tokirobot/PSI1_Hardware/PSI1_STL/bodyframe/main_body.stl

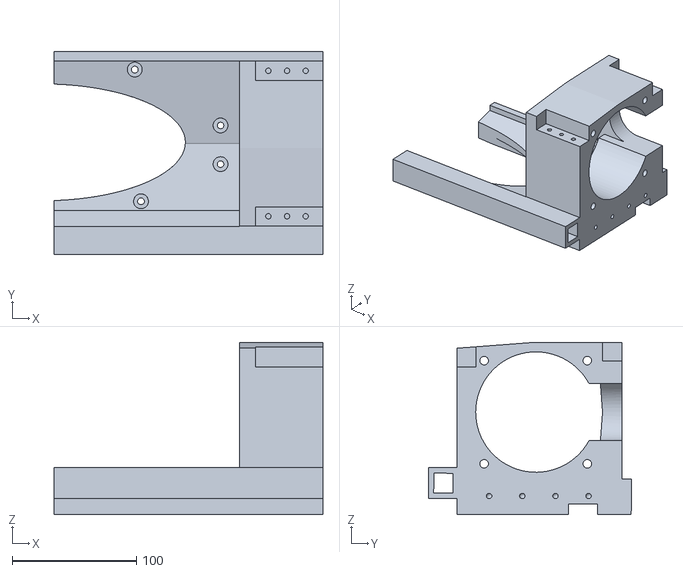
[picture p14: CAD file, 2024-09-26]
PSI1_STL/bodyframe/main_body.stl
216.4 x 163.0 x 138.7
