tokirobot/PSI1_Hardware/PSI1_STEP/bodyframe/body_frame.step

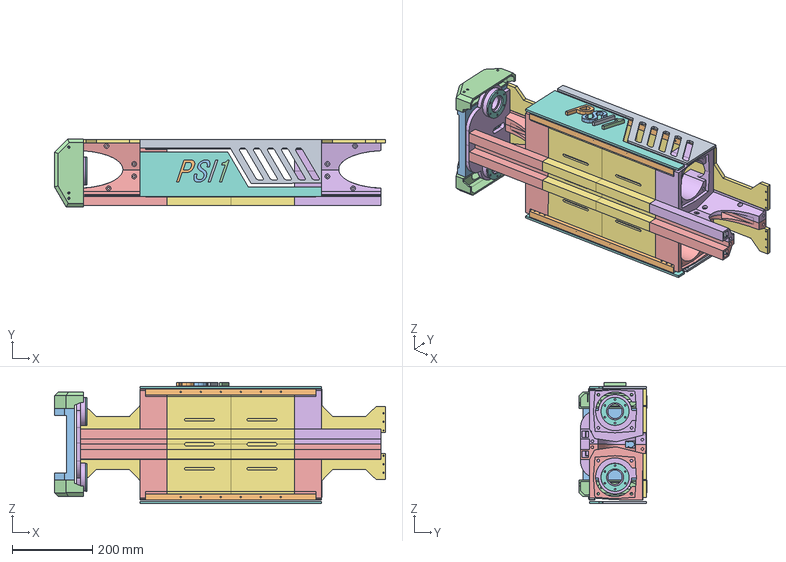
[picture p15: CAD file, 2024-09-26]
PSI1_STEP/bodyframe/body_frame.step
827.0 x 170.4 x 303.1 mm
