tokirobot/PSI1_Hardware/PSI1_STEP/kneedrive/kneedrive.step

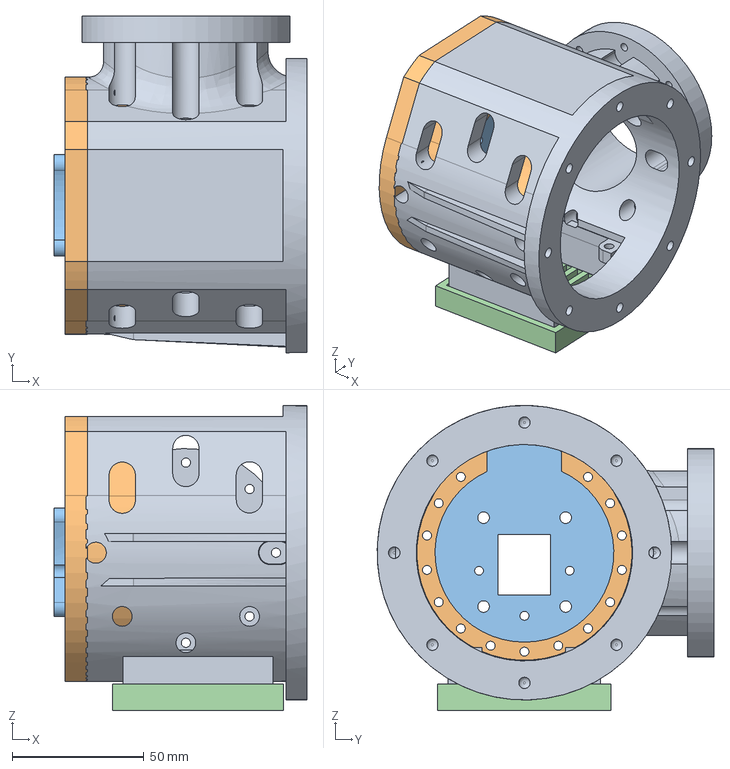
[picture p17: CAD file, 2024-09-26]
PSI1_STEP/kneedrive/kneedrive.step
96.1 x 128.0 x 116.0 mm
