tokirobot/PSI1_Hardware/PSI1_STEP/leg1/linear_slider.step

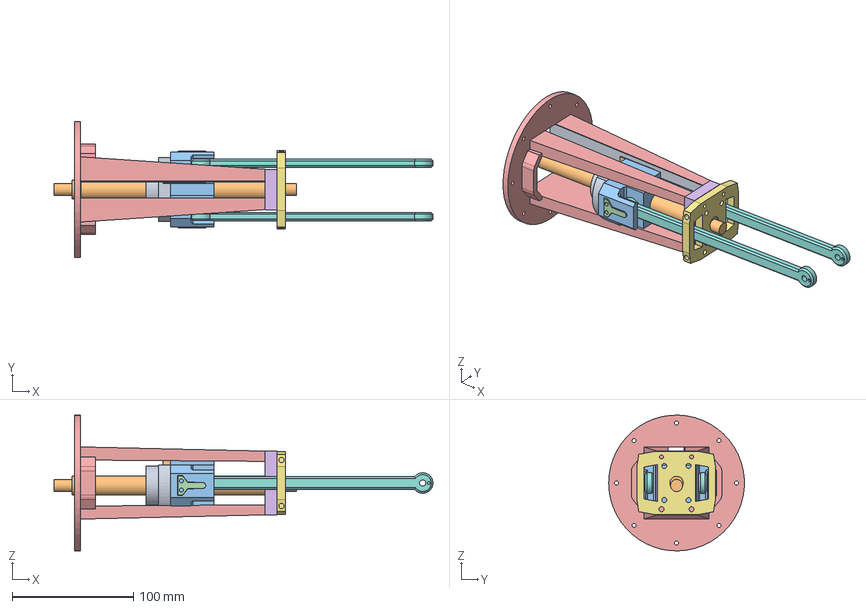
[picture p18: CAD file, 2024-09-26]
PSI1_STEP/leg1/linear_slider.step
312.6 x 111.9 x 111.9 mm
