tokirobot/PSI1_Hardware/PSI1_STEP/leg2/leg2.step

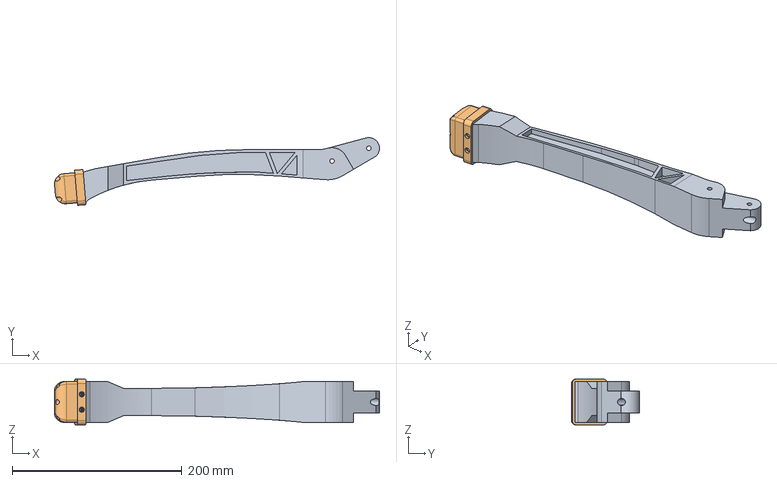
[picture p19: CAD file, 2024-09-26]
PSI1_STEP/leg2/leg2.step
382.8 x 79.9 x 54.0 mm
