tokirobot/PSI1_Hardware/PSI1_STL/bodyframe/yholoder_with_buttoncase.stl

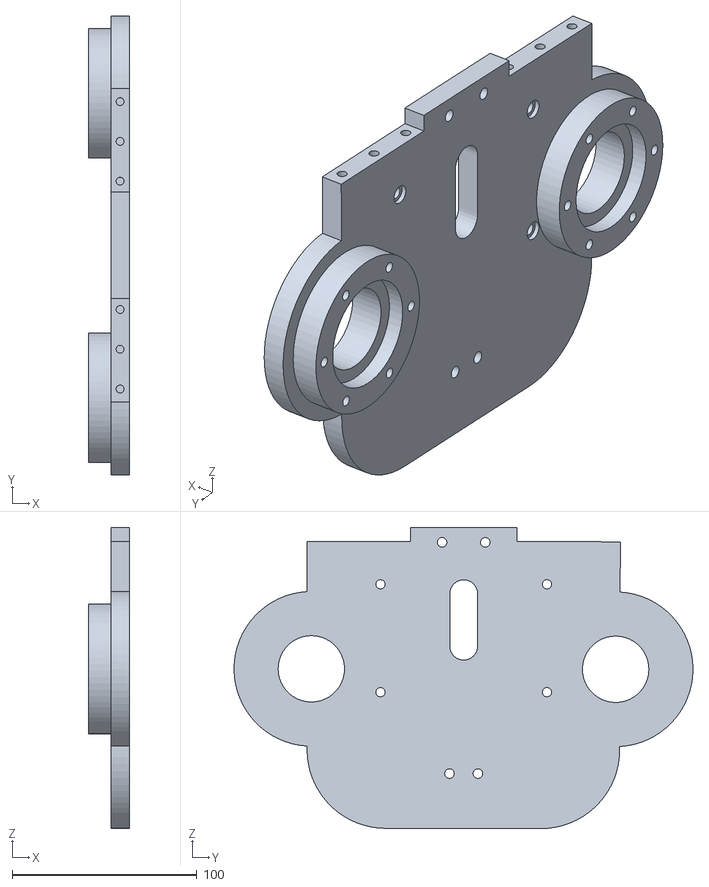
[picture p20: CAD file, 2024-09-26]
PSI1_STL/bodyframe/yholoder_with_buttoncase.stl
22.0 x 248.2 x 162.8
