tokirobot/PSI1_Hardware/PSI1_STL/kneedrive/knee_connector_bottomdown.stl

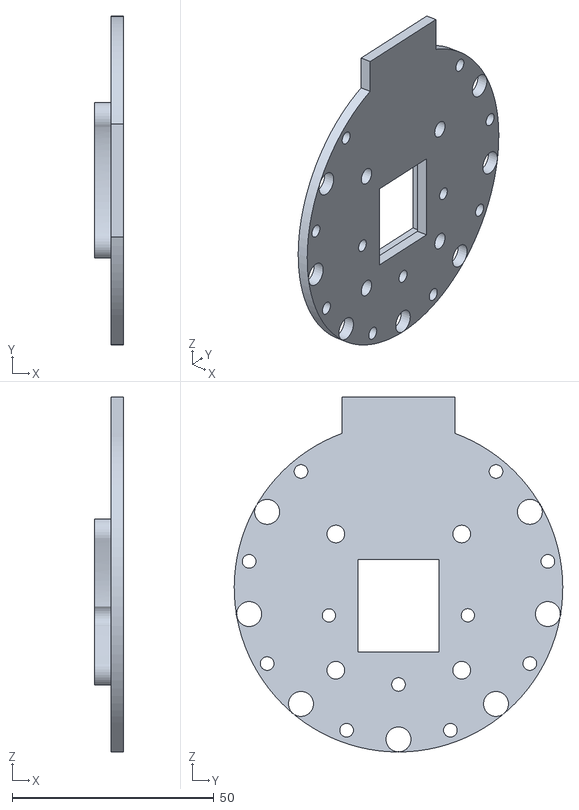
[picture p21: CAD file, 2024-09-26]
PSI1_STL/kneedrive/knee_connector_bottomdown.stl
7.10 x 81.5 x 88.0
