tokirobot/PSI1_Hardware/PSI1_STL/leg2/foot.stl

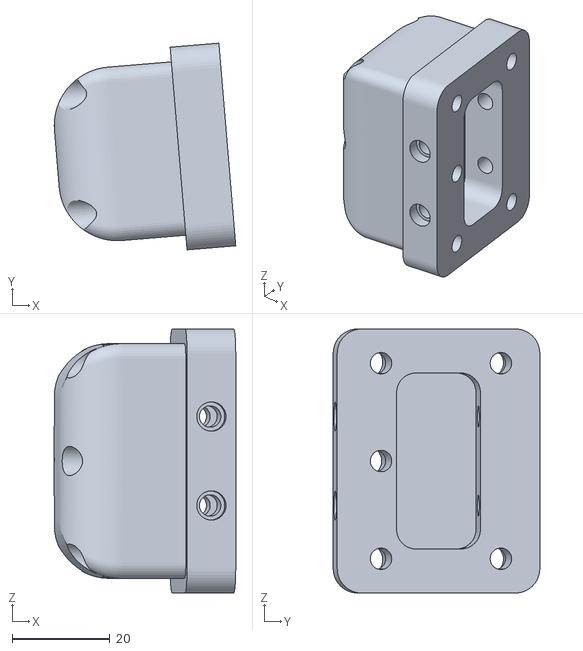
[picture p22: CAD file, 2024-09-26]
PSI1_STL/leg2/foot.stl
37.1 x 42.3 x 54.0
