tokirobot/PSI1_Hardware/PSI1_STL/xaxisdrive/output1_HIP.stl

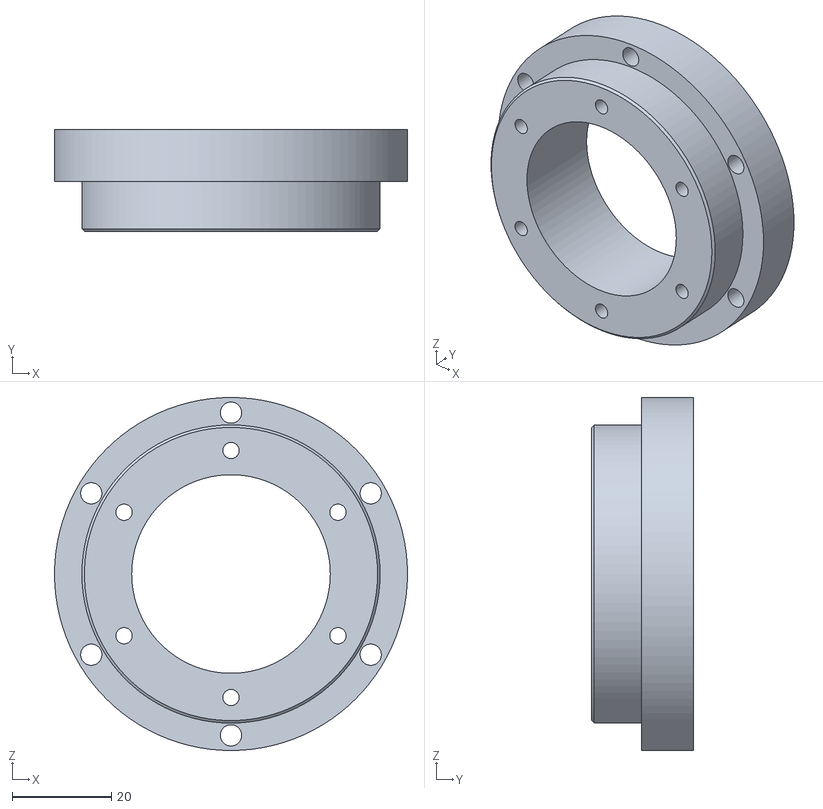
[picture p23: CAD file, 2024-09-26]
PSI1_STL/xaxisdrive/output1_HIP.stl
71.1 x 20.5 x 71.1
