tokirobot/PSI1_Hardware/PSI1_STL/yaxisdrive/sungear.stl

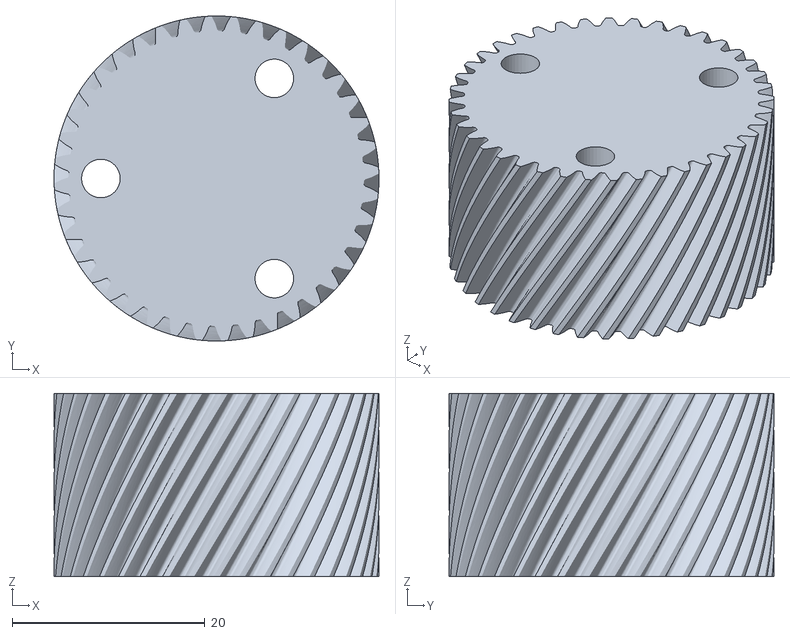
[picture p24: CAD file, 2024-09-26]
PSI1_STL/yaxisdrive/sungear.stl
33.7 x 33.7 x 19.0
