tokirobot/PSI1_Hardware/PSI1_STEP/bodyframe/emergency_button_.step

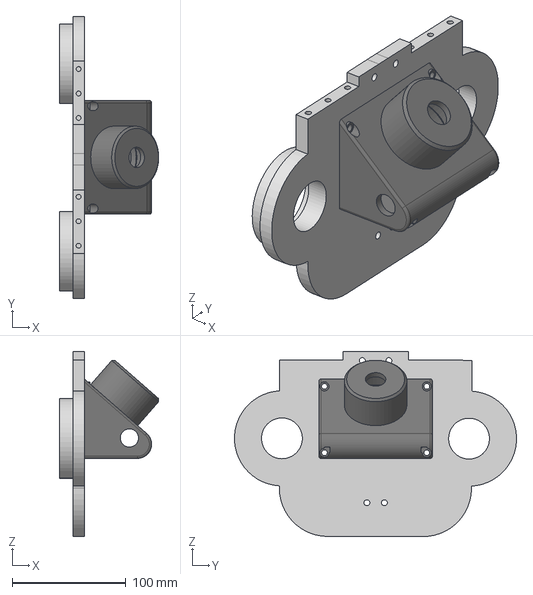
[picture p25: CAD file, 2024-09-26]
PSI1_STEP/bodyframe/emergency_button_.step
87.5 x 248.0 x 162.8 mm
