tokirobot/PSI1_Hardware/PSI1_STEP/leg1/linear_actuator_case.step

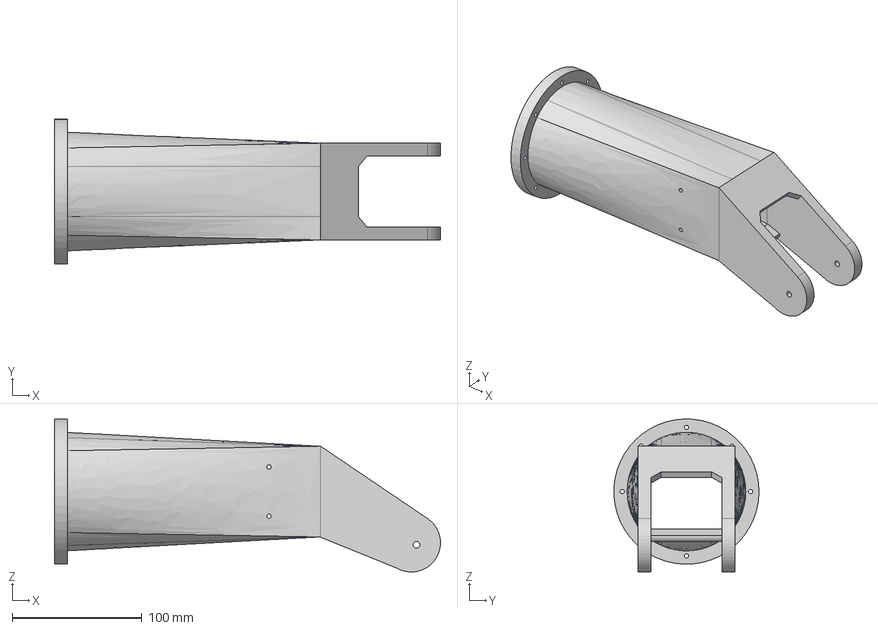
[picture p26: CAD file, 2024-09-26]
PSI1_STEP/leg1/linear_actuator_case.step
297.7 x 111.9 x 118.0 mm
