tokirobot/PSI1_Hardware/PSI1_STL/bodyframe/face_cover_eyeled.stl

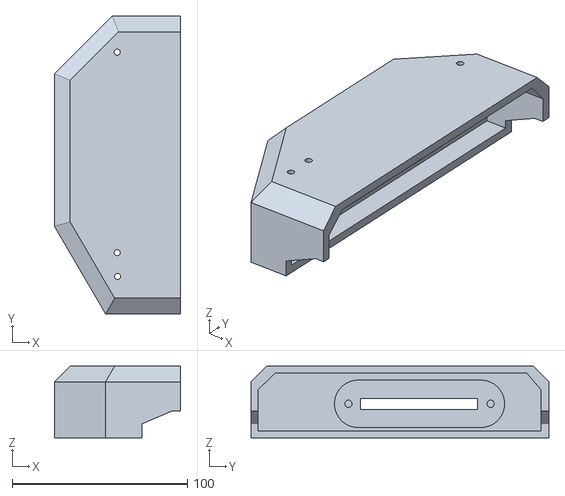
[picture p27: CAD file, 2024-09-26]
PSI1_STL/bodyframe/face_cover_eyeled.stl
72.0 x 170.0 x 41.0
