tokirobot/PSI1_Hardware/PSI1_STL/kneedrive/knee_drive_v2.stl

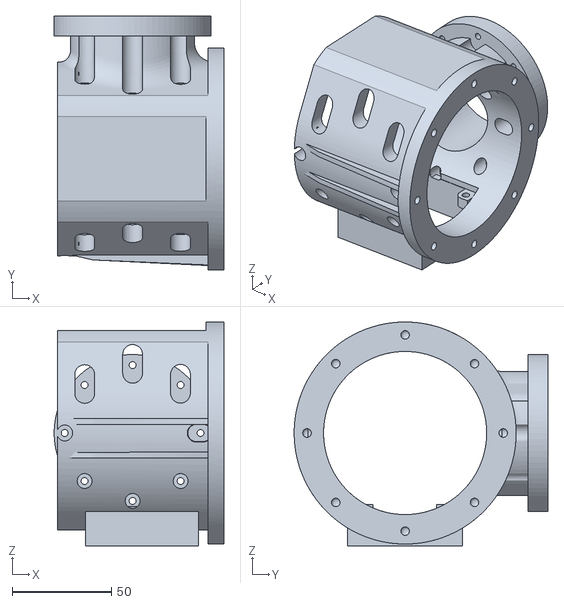
[picture p28: CAD file, 2024-09-26]
PSI1_STL/kneedrive/knee_drive_v2.stl
85.6 x 128.0 x 113.0
