tokirobot/PSI1_Hardware/PSI1_STL/leg1/スライダー滑り2.stl

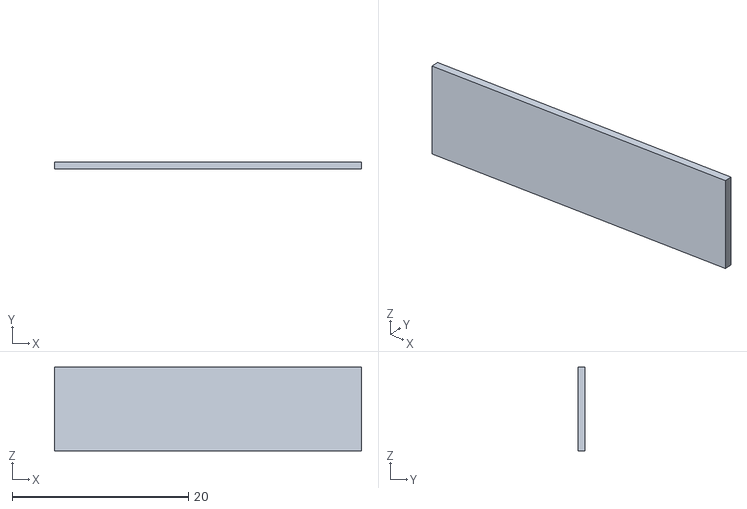
[picture p29: CAD file, 2024-09-26]
PSI1_STL/leg1/スライダー滑り2.stl
34.9 x 0.85 x 9.50
