tokirobot/PSI1_Hardware/PSI1_STL/xaxisdrive/bearingholder_HIP.stl

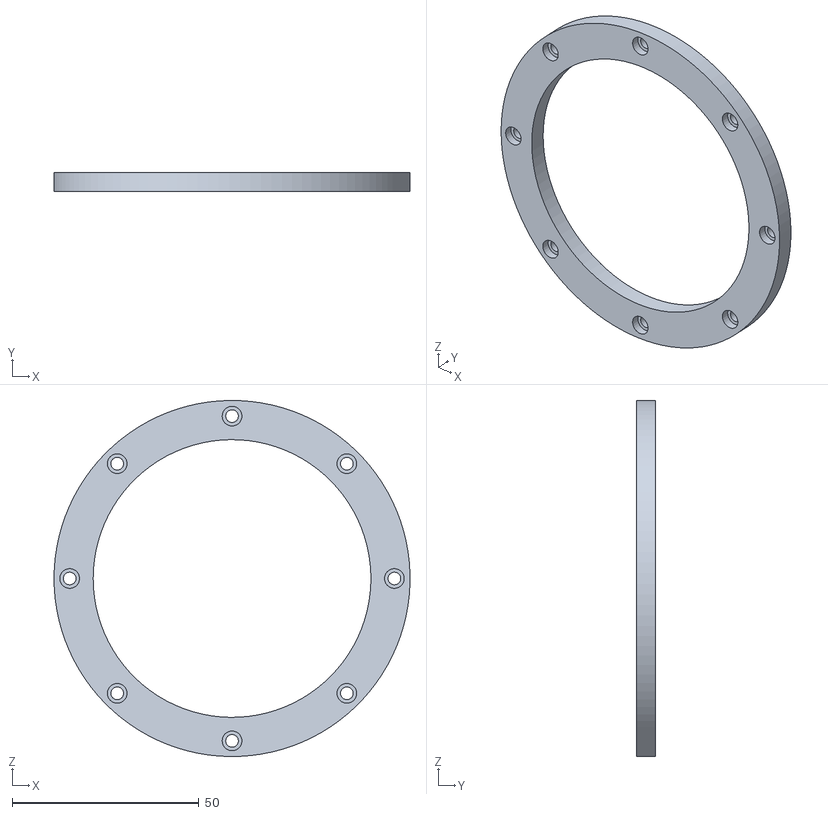
[picture p30: CAD file, 2024-09-26]
PSI1_STL/xaxisdrive/bearingholder_HIP.stl
95.4 x 5.00 x 95.4
