tokirobot/PSI1_Hardware/PSI1_STL/bodyframe/P.stl

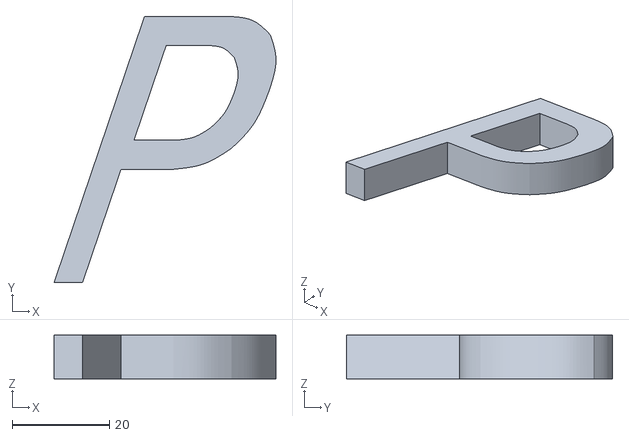
[picture p31: CAD file, 2024-09-26]
PSI1_STL/bodyframe/P.stl
45.8 x 54.9 x 9.00
