tokirobot/PSI1_Hardware/PSI1_STL/kneedrive/knee_motor_holder_bottomdown.stl

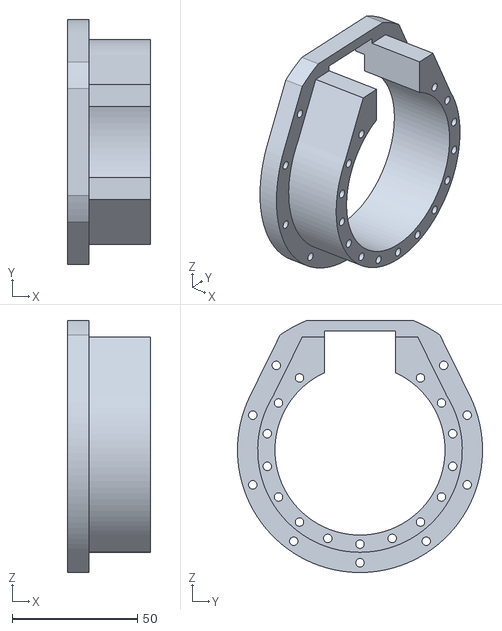
[picture p32: CAD file, 2024-09-26]
PSI1_STL/kneedrive/knee_motor_holder_bottomdown.stl
33.0 x 98.0 x 100.8
