tokirobot/PSI1_Hardware/PSI1_STL/leg1/lod_holder.stl

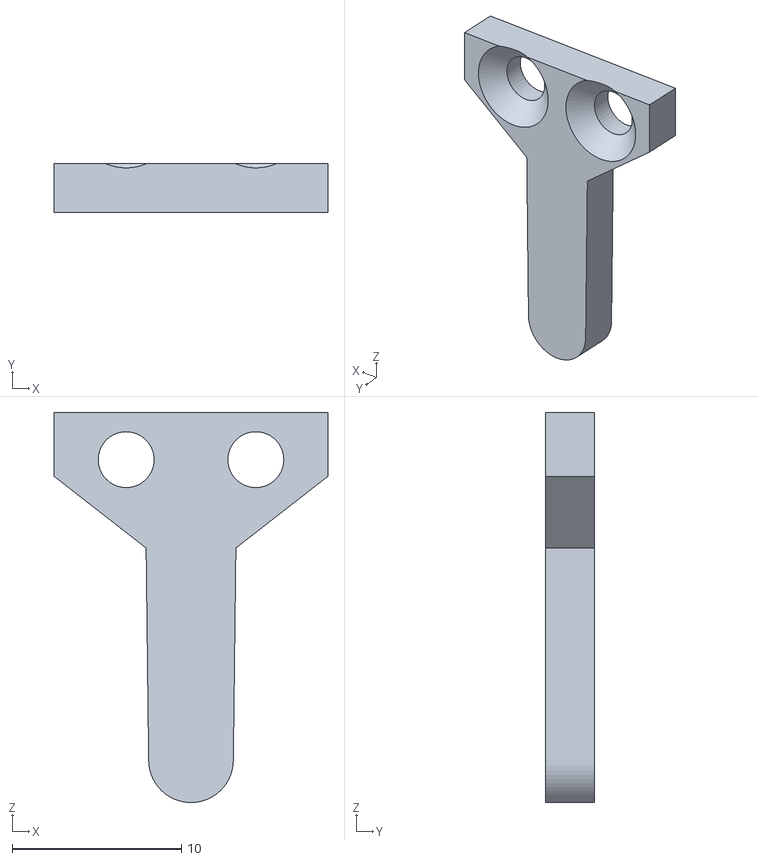
[picture p33: CAD file, 2024-09-26]
PSI1_STL/leg1/lod_holder.stl
16.2 x 2.90 x 23.0
