tokirobot/PSI1_Hardware/PSI1_STL/xaxisdrive/motor_mount_HIP.stl

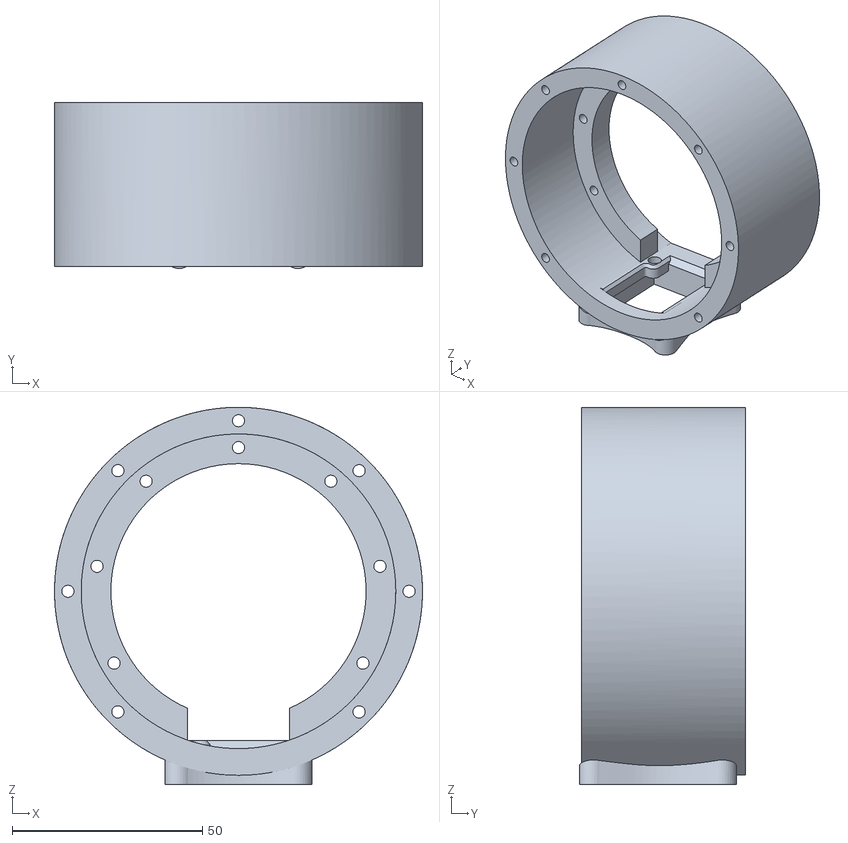
[picture p34: CAD file, 2024-09-26]
PSI1_STL/xaxisdrive/motor_mount_HIP.stl
96.6 x 43.6 x 99.1
