tokirobot/PSI1_Hardware/PSI1_STL/yaxisdrive/planetary_career_bottom.stl

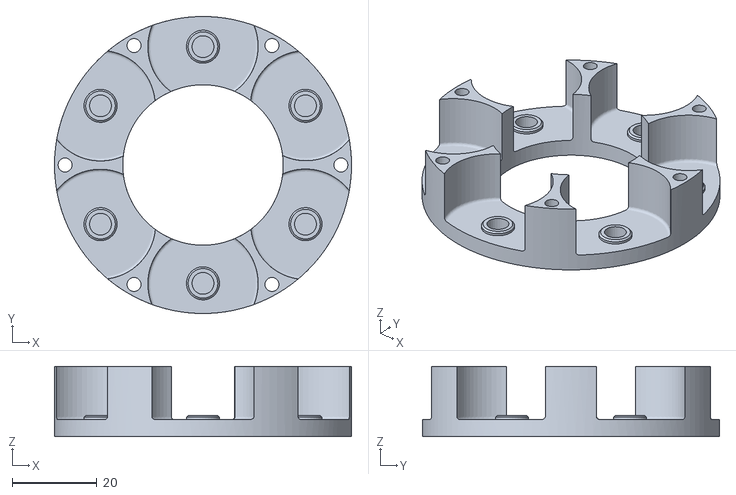
[picture p35: CAD file, 2024-09-26]
PSI1_STL/yaxisdrive/planetary_career_bottom.stl
70.0 x 70.0 x 16.5
