tokirobot/PSI1_Hardware/PSI1_STL/kneedrive/fancase.stl

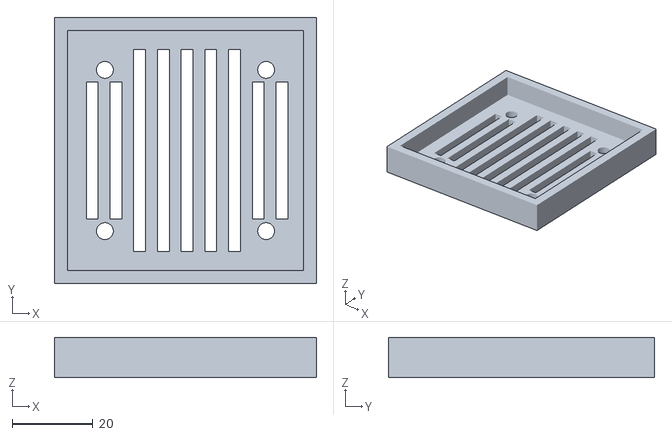
[picture p37: CAD file, 2024-09-26]
PSI1_STL/kneedrive/fancase.stl
65.0 x 66.0 x 10.0
