tokirobot/PSI1_Hardware/PSI1_STL/leg1/linear_frame_v2.stl

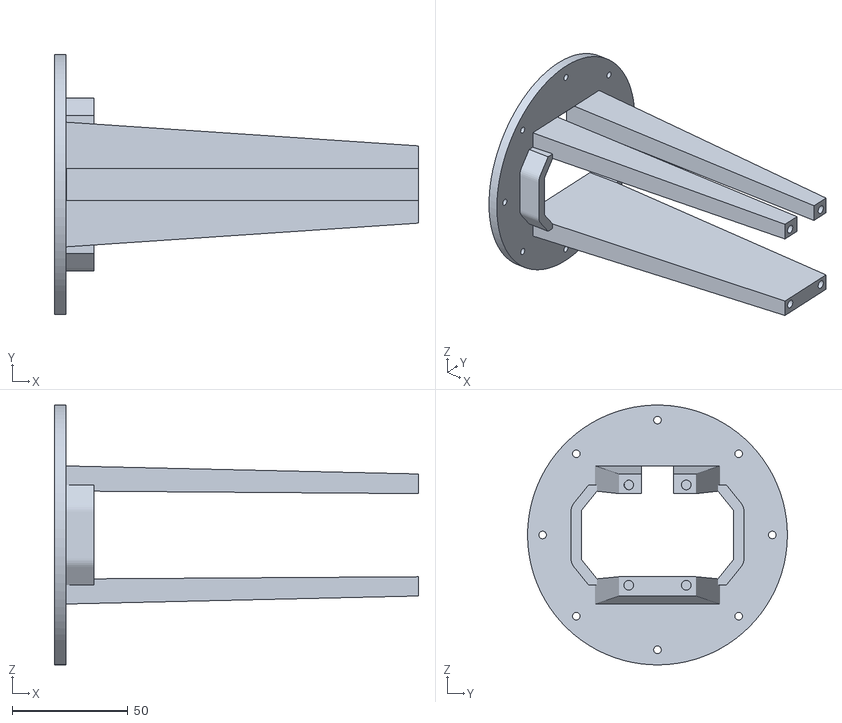
[picture p38: CAD file, 2024-09-26]
PSI1_STL/leg1/linear_frame_v2.stl
156.9 x 112.0 x 112.0
