tokirobot/PSI1_Hardware/PSI1_STL/xaxisdrive/cybercase.stl

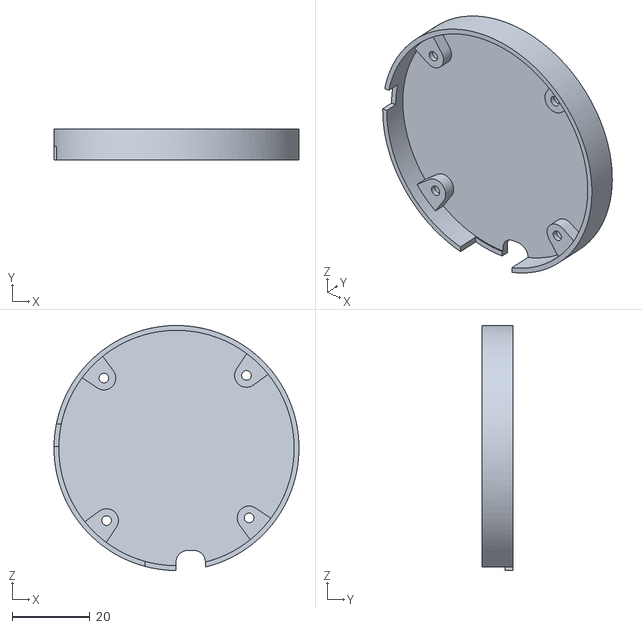
[picture p39: CAD file, 2024-09-26]
PSI1_STL/xaxisdrive/cybercase.stl
63.2 x 7.90 x 63.2
