tokirobot/PSI1_Hardware/PSI1_STL/yaxisdrive/planetary_career_top.stl

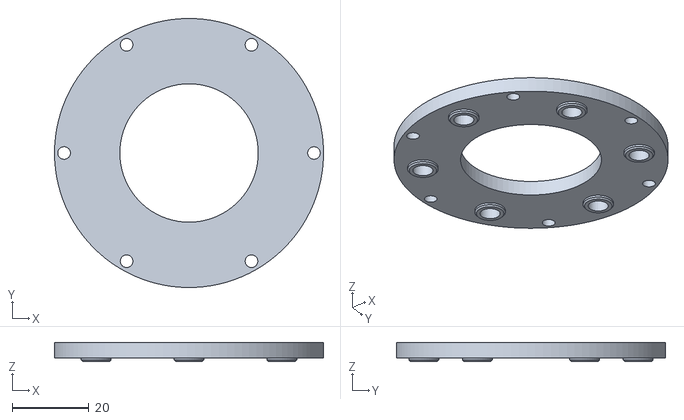
[picture p40: CAD file, 2024-09-26]
PSI1_STL/yaxisdrive/planetary_career_top.stl
70.0 x 70.0 x 4.95
