tokirobot/PSI1_Hardware/PSI1_STL/bodyframe/under_frame.stl

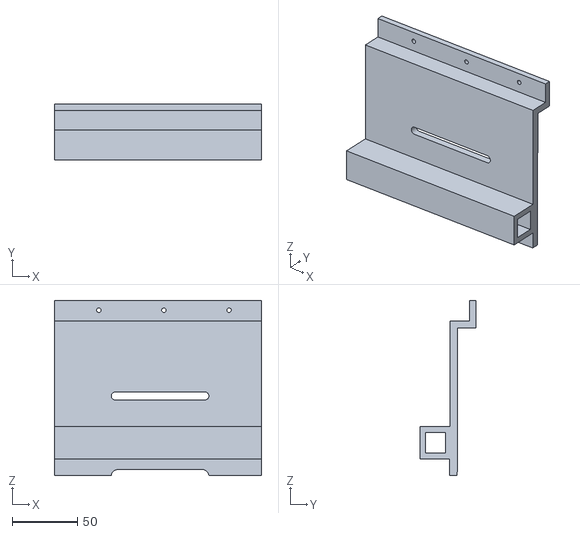
[picture p41: CAD file, 2024-09-26]
PSI1_STL/bodyframe/under_frame.stl
159.0 x 42.9 x 134.5
