tokirobot/PSI1_Hardware/PSI1_STL/yaxisdrive/connector_SHOULDER.stl

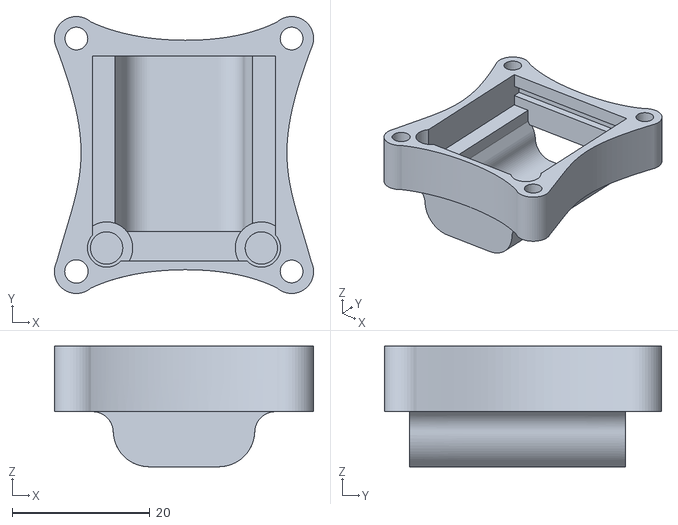
[picture p43: CAD file, 2024-09-26]
PSI1_STL/yaxisdrive/connector_SHOULDER.stl
37.6 x 40.2 x 17.5
