tokirobot/PSI1_Hardware/PSI1_STL/bodyframe/I.stl

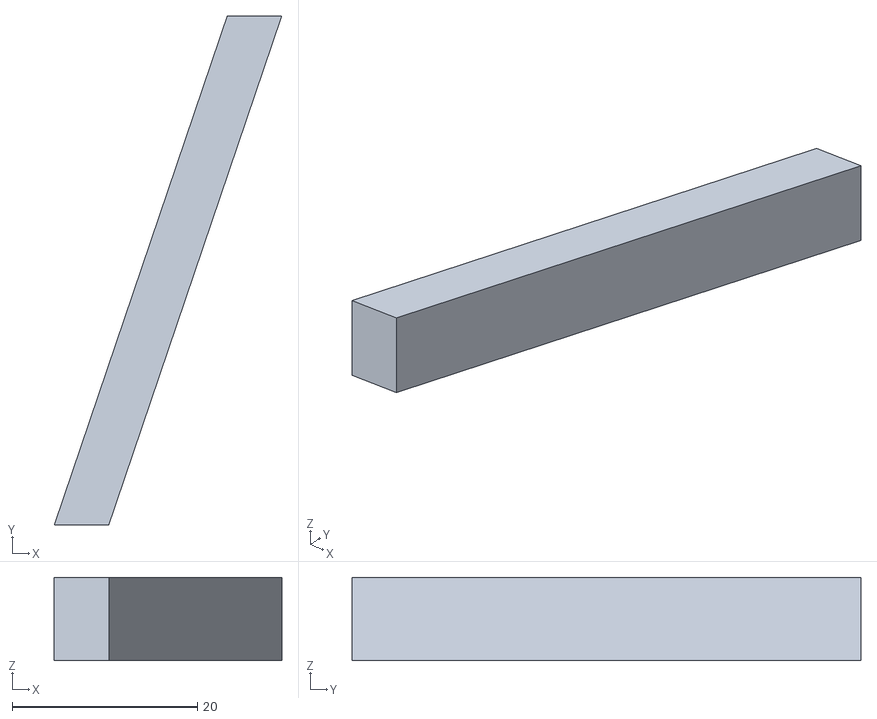
[picture p44: CAD file, 2024-09-26]
PSI1_STL/bodyframe/I.stl
24.5 x 54.9 x 9.00
