tokirobot/PSI1_Hardware/PSI1_STL/leg1/linear_frame_holder.stl

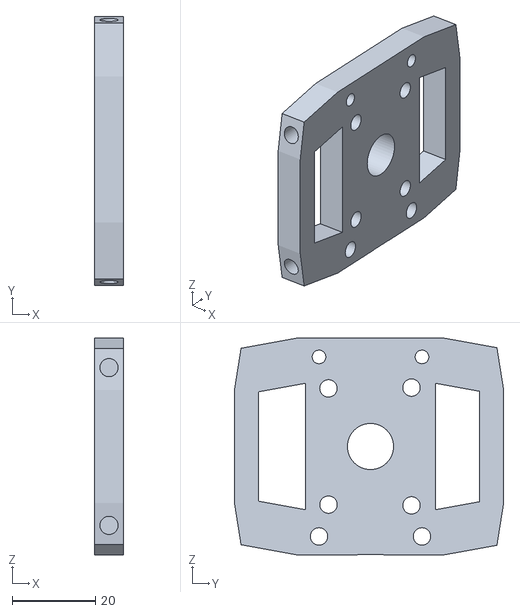
[picture p45: CAD file, 2024-09-26]
PSI1_STL/leg1/linear_frame_holder.stl
7.00 x 64.8 x 52.3
