tokirobot/PSI1_Hardware/PSI1_STL/xaxisdrive/planetary_98%.stl

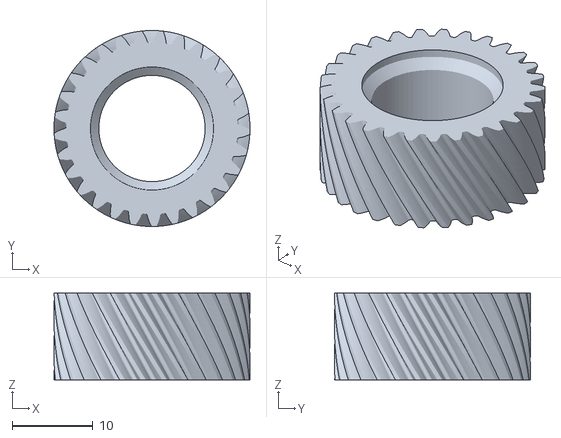
[picture p46: CAD file, 2024-09-26]
PSI1_STL/xaxisdrive/planetary_98%.stl
24.3 x 24.3 x 10.8
