tokirobot/PSI1_Hardware/PSI1_STL/yaxisdrive/Y_axis_holder_SHOULDER.stl

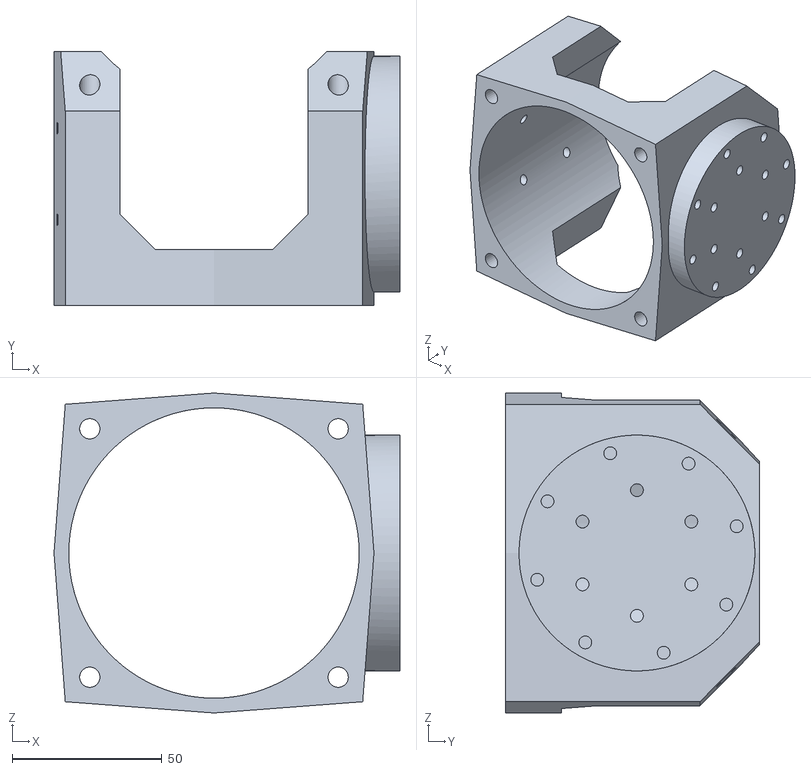
[picture p47: CAD file, 2024-09-26]
PSI1_STL/yaxisdrive/Y_axis_holder_SHOULDER.stl
115.6 x 85.0 x 106.9
