tokirobot/PSI1_Hardware/PSI1_STL/bodyframe/y_bearing_holder.stl

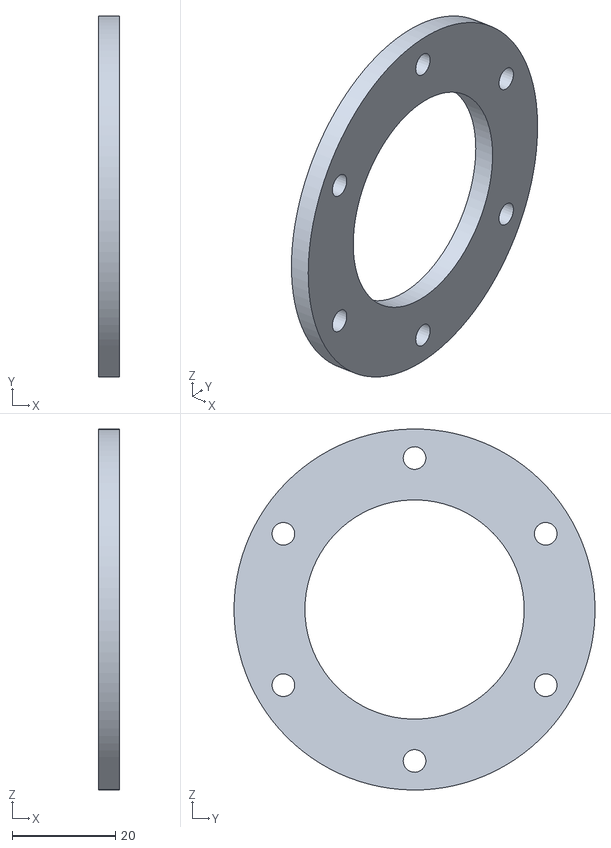
[picture p48: CAD file, 2024-09-26]
PSI1_STL/bodyframe/y_bearing_holder.stl
4.00 x 70.0 x 70.0
