tokirobot/PSI1_Hardware/PSI1_STL/leg1/回転支え2.stl

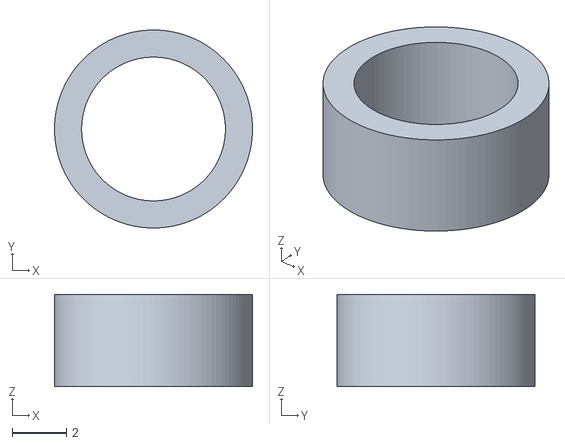
[picture p49: CAD file, 2024-09-26]
PSI1_STL/leg1/回転支え2.stl
7.30 x 7.30 x 3.40
