tokirobot/PSI1_Hardware/PSI1_STL/yaxisdrive/output2_SHOULDER.stl

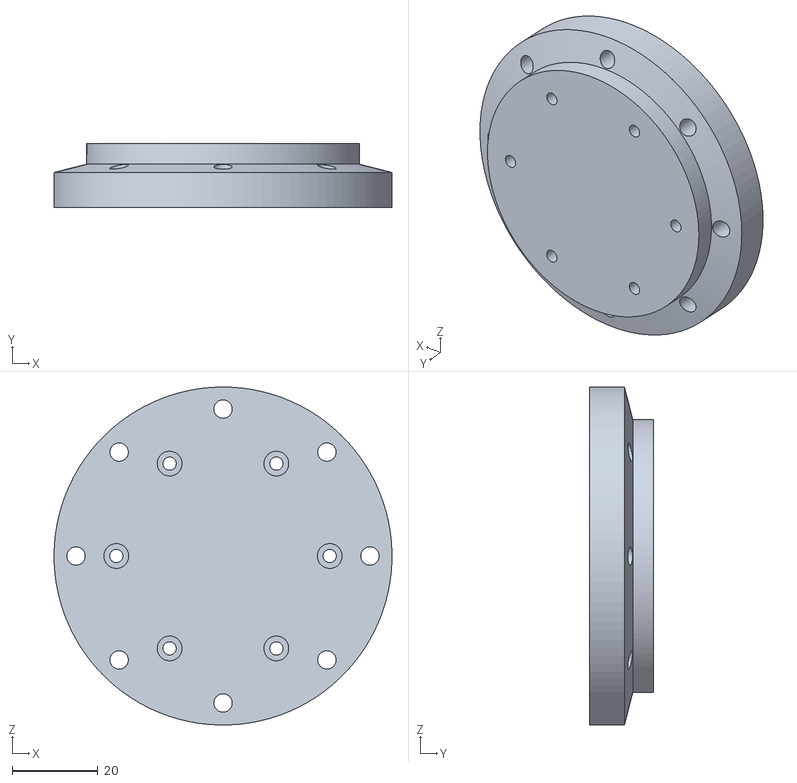
[picture p50: CAD file, 2024-09-26]
PSI1_STL/yaxisdrive/output2_SHOULDER.stl
78.8 x 15.0 x 78.8
