tokirobot/PSI1_Hardware/PSI1_STL/leg1/スライダー滑り1.stl

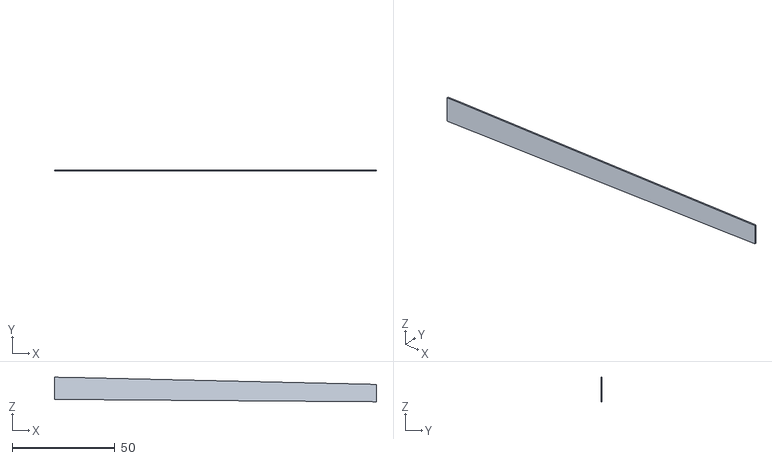
[picture p51: CAD file, 2024-09-26]
PSI1_STL/leg1/スライダー滑り1.stl
156.9 x 0.7 x 12.0
