tokirobot/PSI1_Hardware/PSI1_STL/yaxisdrive/CS1_SHOULDER_3.45.stl

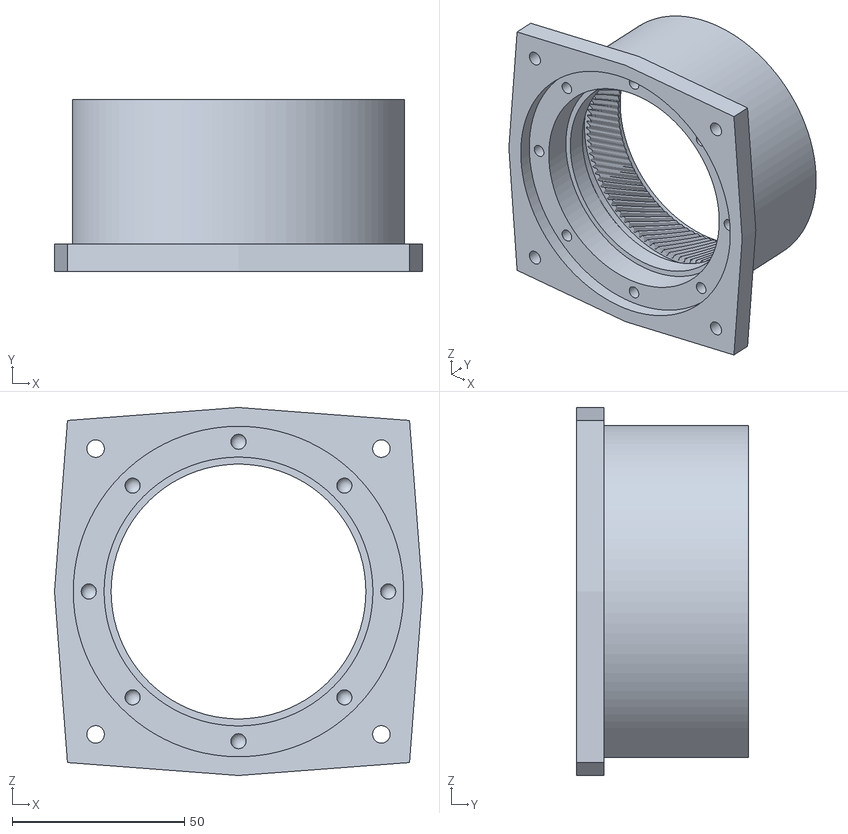
[picture p52: CAD file, 2024-09-26]
PSI1_STL/yaxisdrive/CS1_SHOULDER_3.45.stl
106.9 x 50.0 x 106.9
