tokirobot/PSI1_Hardware/PSI1_STL/bodyframe/emergency_button_case.stl

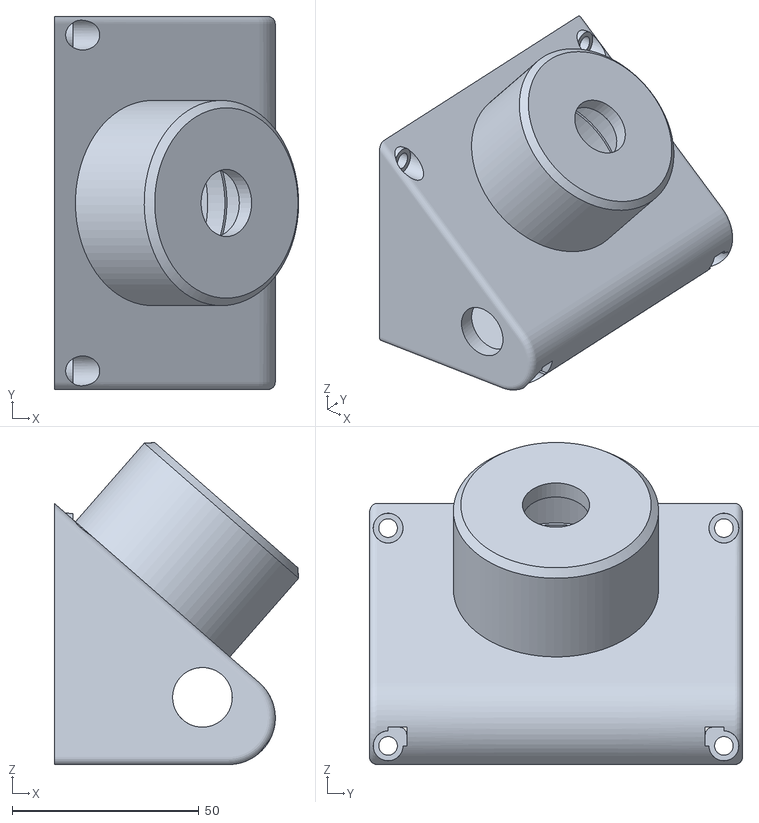
[picture p53: CAD file, 2024-09-26]
PSI1_STL/bodyframe/emergency_button_case.stl
65.5 x 100.0 x 86.3
