tokirobot/PSI1_Hardware/PSI1_STL/leg1/lod.stl

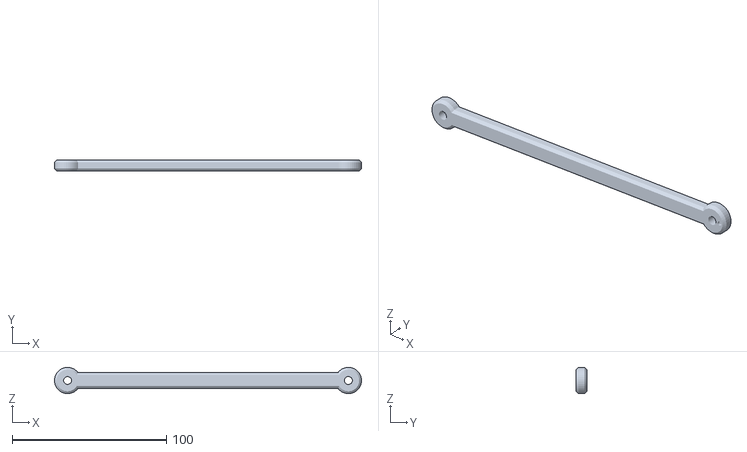
[picture p54: CAD file, 2024-09-26]
PSI1_STL/leg1/lod.stl
198.9 x 7.00 x 17.0
