tokirobot/PSI1_Hardware/PSI1_STL/yaxisdrive/output1_SHOULDER.stl

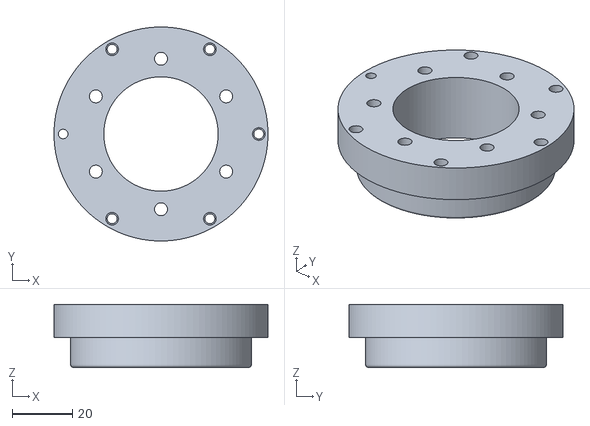
[picture p55: CAD file, 2024-09-26]
PSI1_STL/yaxisdrive/output1_SHOULDER.stl
71.1 x 71.1 x 21.0
