tokirobot/PSI1_Hardware/PSI1_STL/bodyframe/yholder.stl

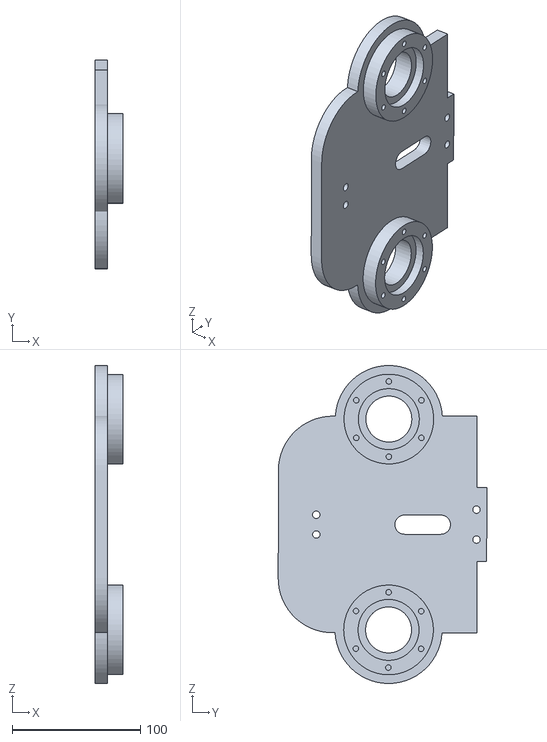
[picture p56: CAD file, 2024-09-26]
PSI1_STL/bodyframe/yholder.stl
22.0 x 162.8 x 248.2
