tokirobot/PSI1_Hardware/PSI1_STL/leg1/slider.stl

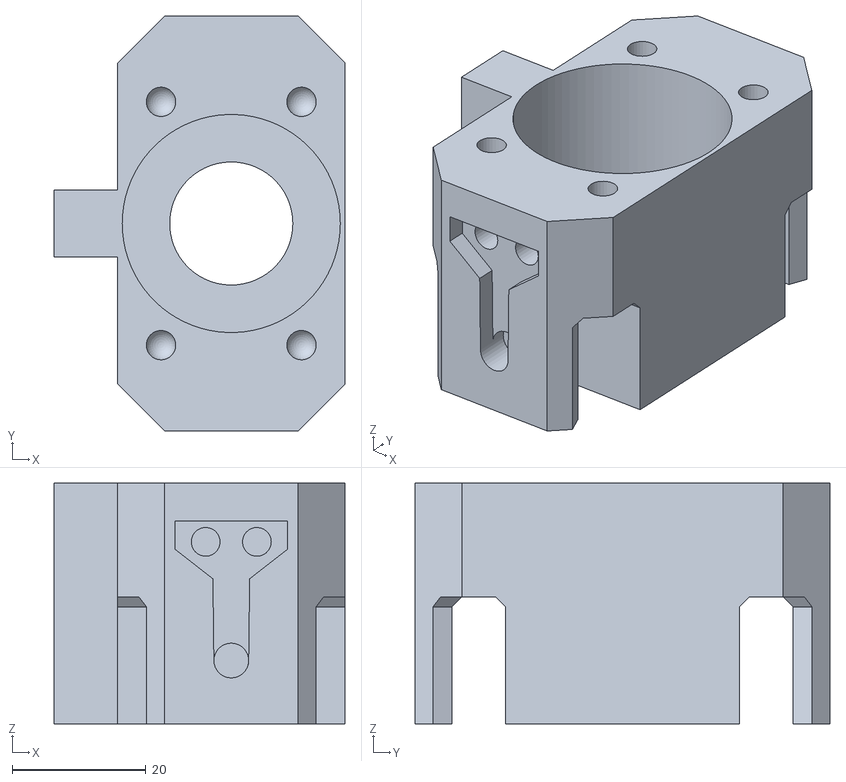
[picture p57: CAD file, 2024-09-26]
PSI1_STL/leg1/slider.stl
43.5 x 62.0 x 36.0
