tokirobot/PSI1_Hardware/PSI1_STL/bodyframe/face.stl

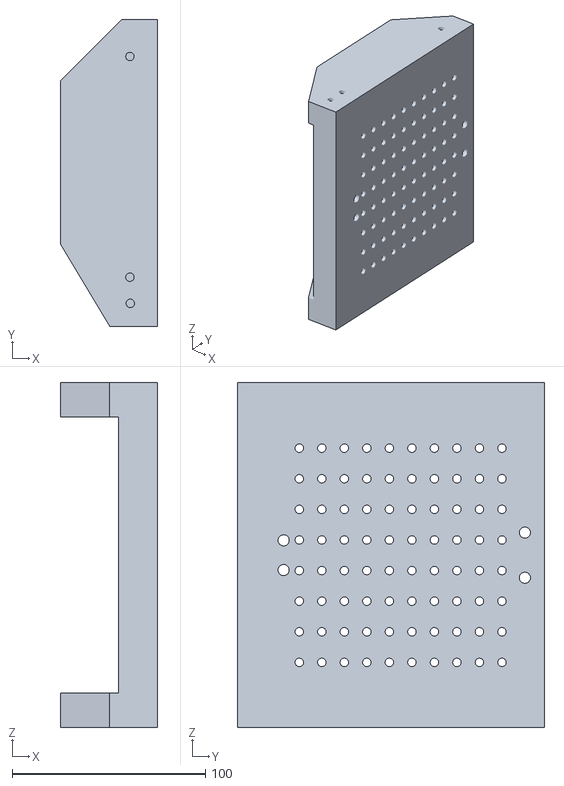
[picture p58: CAD file, 2024-09-26]
PSI1_STL/bodyframe/face.stl
50.0 x 158.9 x 178.8
