tokirobot/PSI1_Hardware/PSI1_STL/bodyframe/S.stl

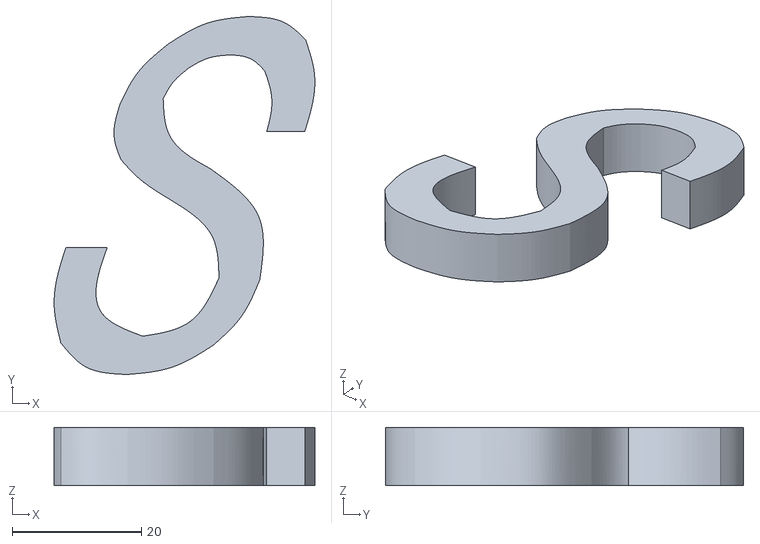
[picture p59: CAD file, 2024-09-26]
PSI1_STL/bodyframe/S.stl
40.4 x 55.4 x 9.00
