tokirobot/PSI1_Hardware/(list of files, cad)

Other CAD files:
PSI1_STL/yaxisdrive/bearingholder_SHOULDER.stl
PSI1_STL/xaxisdrive/CS1_HIP_3.45.stl
PSI1_STL/xaxisdrive/output2_HIP.stl
PSI1_STL/leg1/ball_screw_holder_12mm.stl
PSI1_STL/leg1/linear_actuator_case.stl
PSI1_STL/leg2/leg2.stl
